LimeProgramming/NLIME_Slimes/README.md

> [!WARNING]
> This has not been made ***yet*** so not confirmed working. While you're free to make it anyway, do not blame me if it doesn't work. You have been warned.

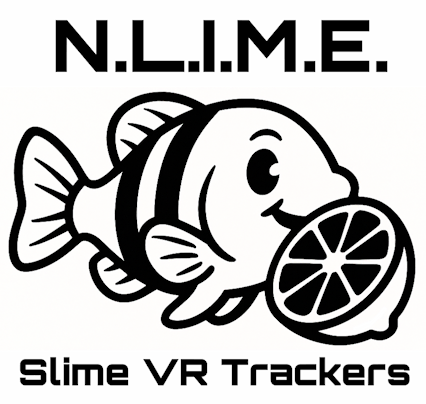
[picture p1: Images/LOGO/NLIME.webp]
NLime-Logo


## NLIME_Slimes
SMOL Slime VR trackers based around nRF52840, intended to be similar form factor to commercial Slimes but smaller.

I kinda like them. 

TODO: Write a proper read me maybe later. 

> [!NOTE]
> This was made with KICAD 9 and for some reason opening this project with KICAD 8 corrupts the PCB file.

> [!NOTE]
> Weird print settings
> 0.48 mm wall thickness
> layer 1 height 0.3mm
> layer height 0.26mm
