LimeProgramming/NLIME_Slimes/Images/Render/back-noTHT.png

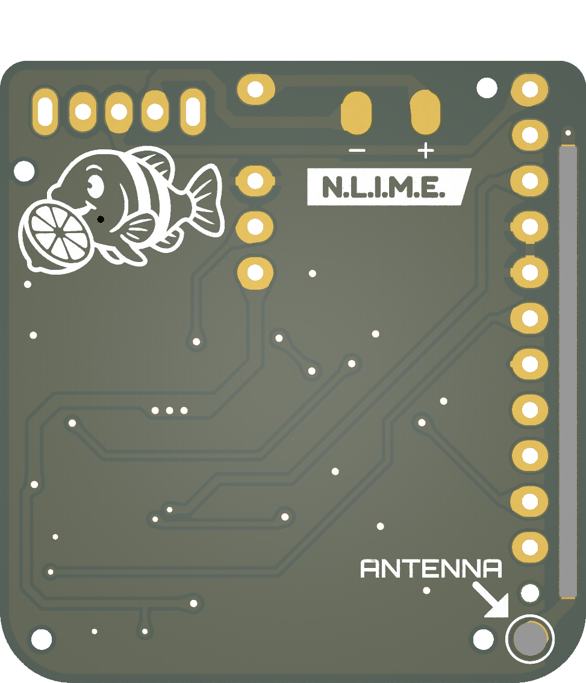
Images/Render/back-noTHT.png
