LimeProgramming/NLIME_Slimes/Images/Render/back-THT.png

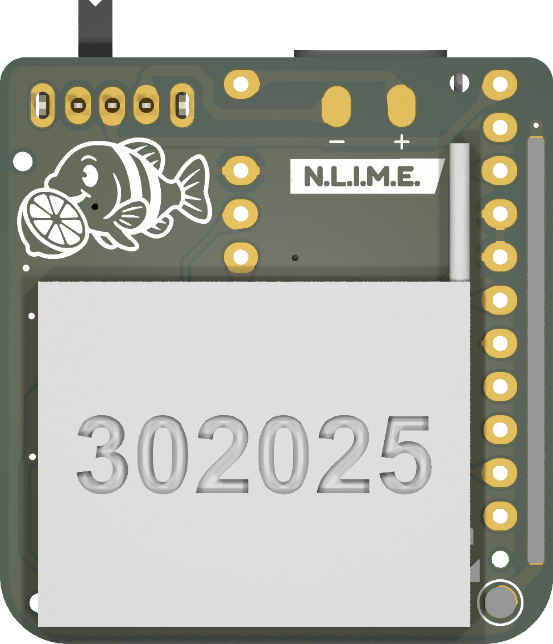
Images/Render/back-THT.png
