LimeProgramming/NLIME_Slimes/Images/Render/front-NOTHT.png

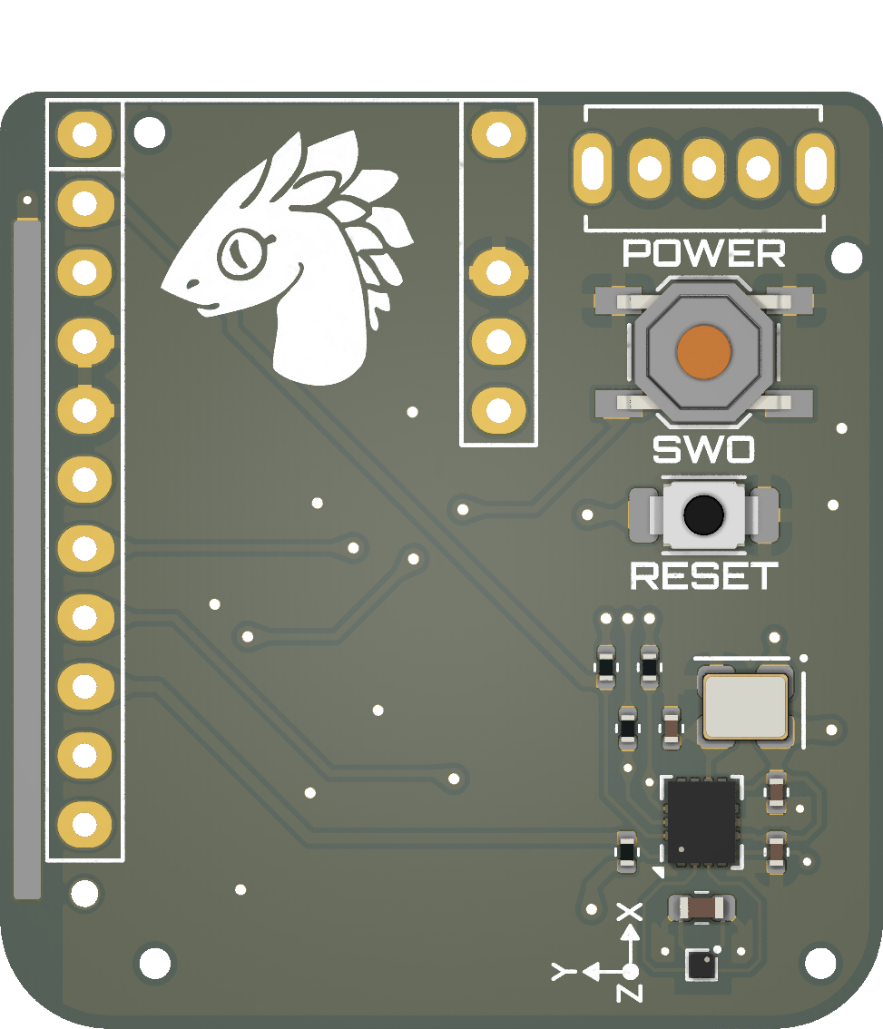
Images/Render/front-NOTHT.png
