LimeProgramming/NLIME_Slimes/Images/Render/front-THT.png

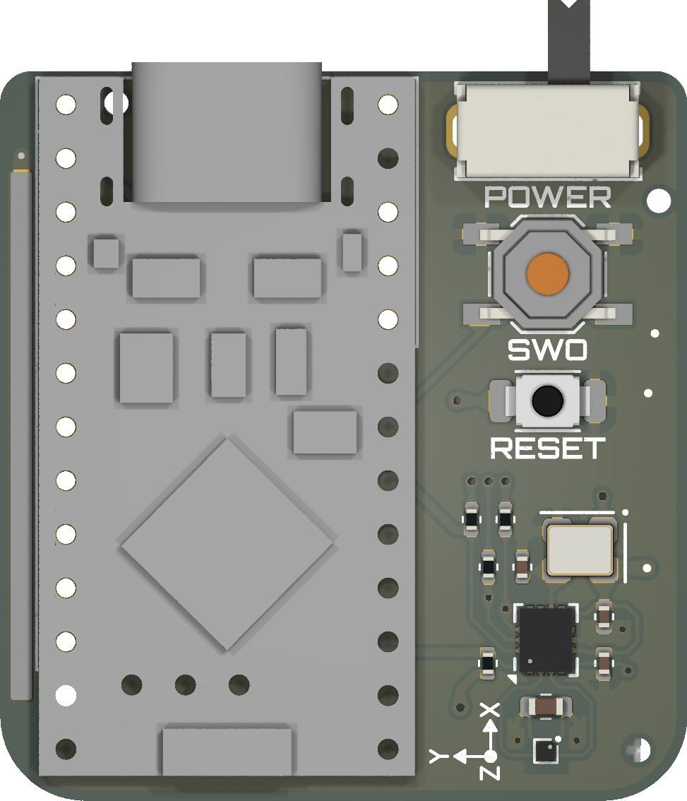
Images/Render/front-THT.png
