LimeProgramming/NLIME_Slimes/Case/Top Joined switchless.stl

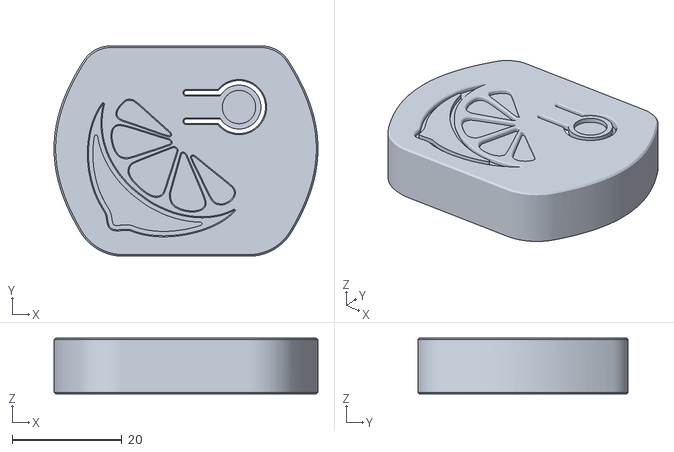
[picture p6: CAD file, 2025-08-19]
Case/Top Joined switchless.stl
48.1 x 38.3 x 10.2
