LimeProgramming/NLIME_Slimes/Case/Top Joined Switched.stl

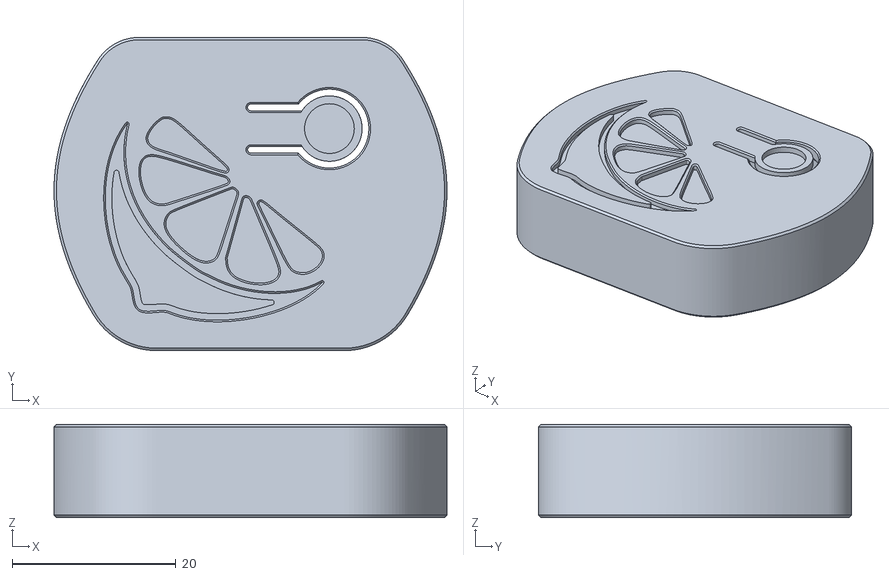
[picture p7: CAD file, 2025-08-19]
Case/Top Joined Switched.stl
48.1 x 38.3 x 11.4
