LimeProgramming/NLIME_Slimes/Case/Bottom 302025 curved straps.stl

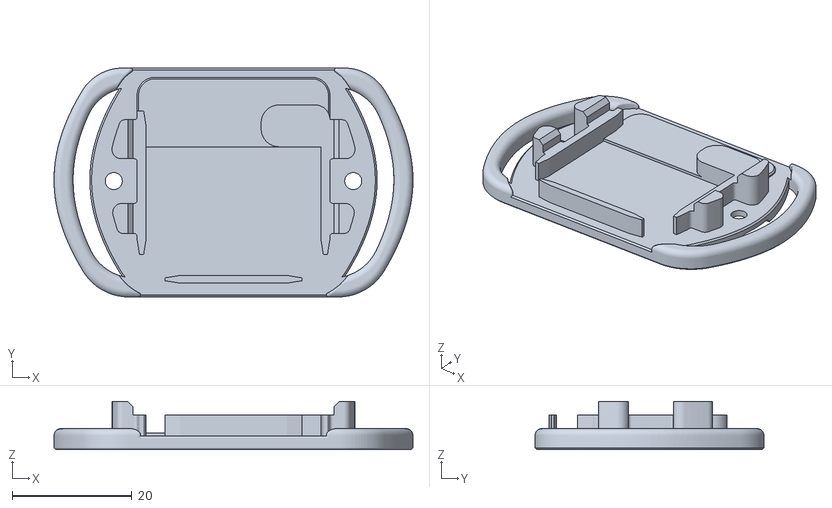
[picture p8: CAD file, 2025-08-19]
Case/Bottom 302025 curved straps.stl
60.0 x 38.3 x 8.05
