LimeProgramming/NLIME_Slimes/Case/bottom 302025 no straps v3.stl

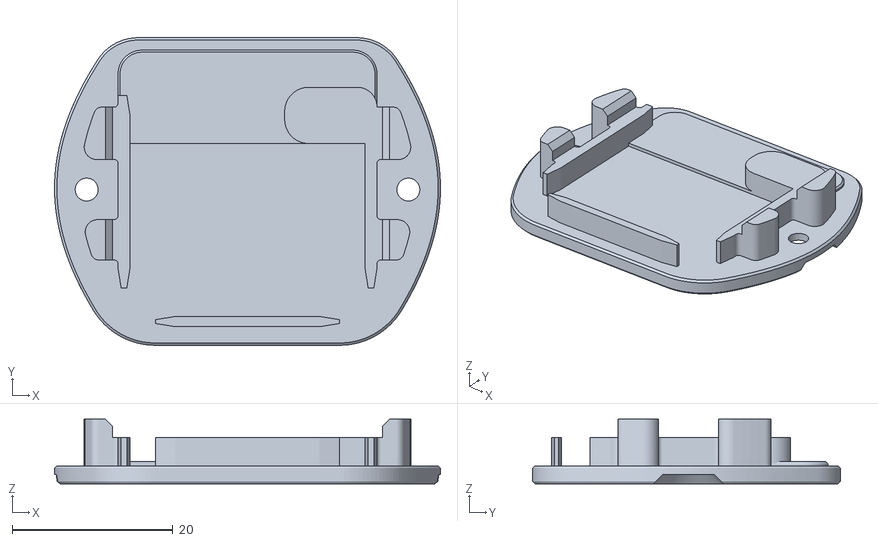
[picture p9: CAD file, 2025-08-19]
Case/bottom 302025 no straps v3.stl
48.1 x 38.3 x 8.05
