LimeProgramming/NLIME_Slimes/Case/bottom 502025 curved straps.stl

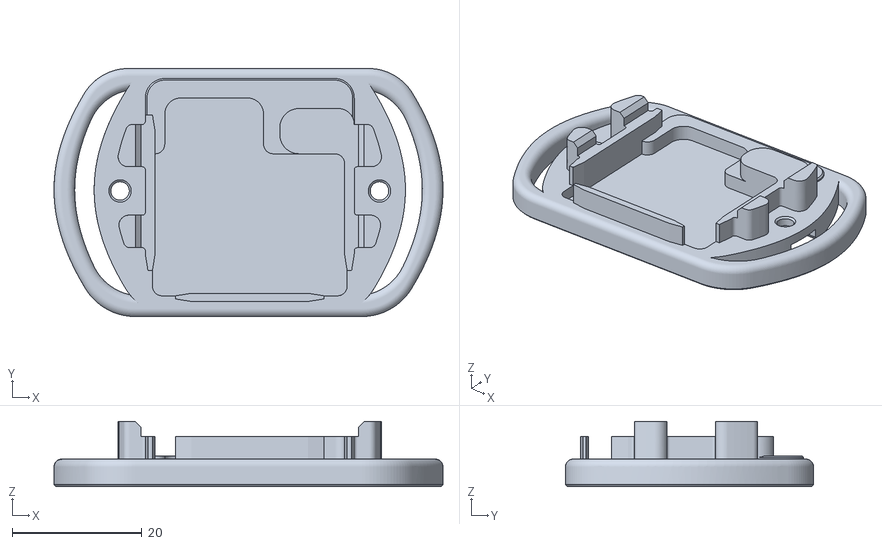
[picture p10: CAD file, 2025-08-19]
Case/bottom 502025 curved straps.stl
60.0 x 38.3 x 10.0
