LimeProgramming/NLIME_Slimes/Case/bottom 502025 no strap.stl

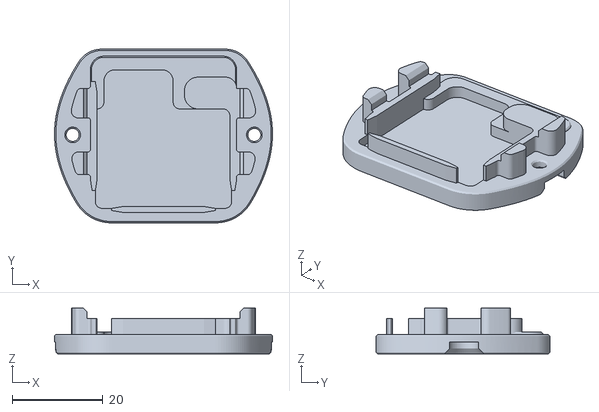
[picture p11: CAD file, 2025-08-19]
Case/bottom 502025 no strap.stl
48.1 x 38.3 x 10.0
