LimeProgramming/NLIME_Slimes/KICAD Files/NLIME_Slime.kicad_pcb

## KiCad design KICAD Files/NLIME_Slime.kicad_pcb (2025-08-19)

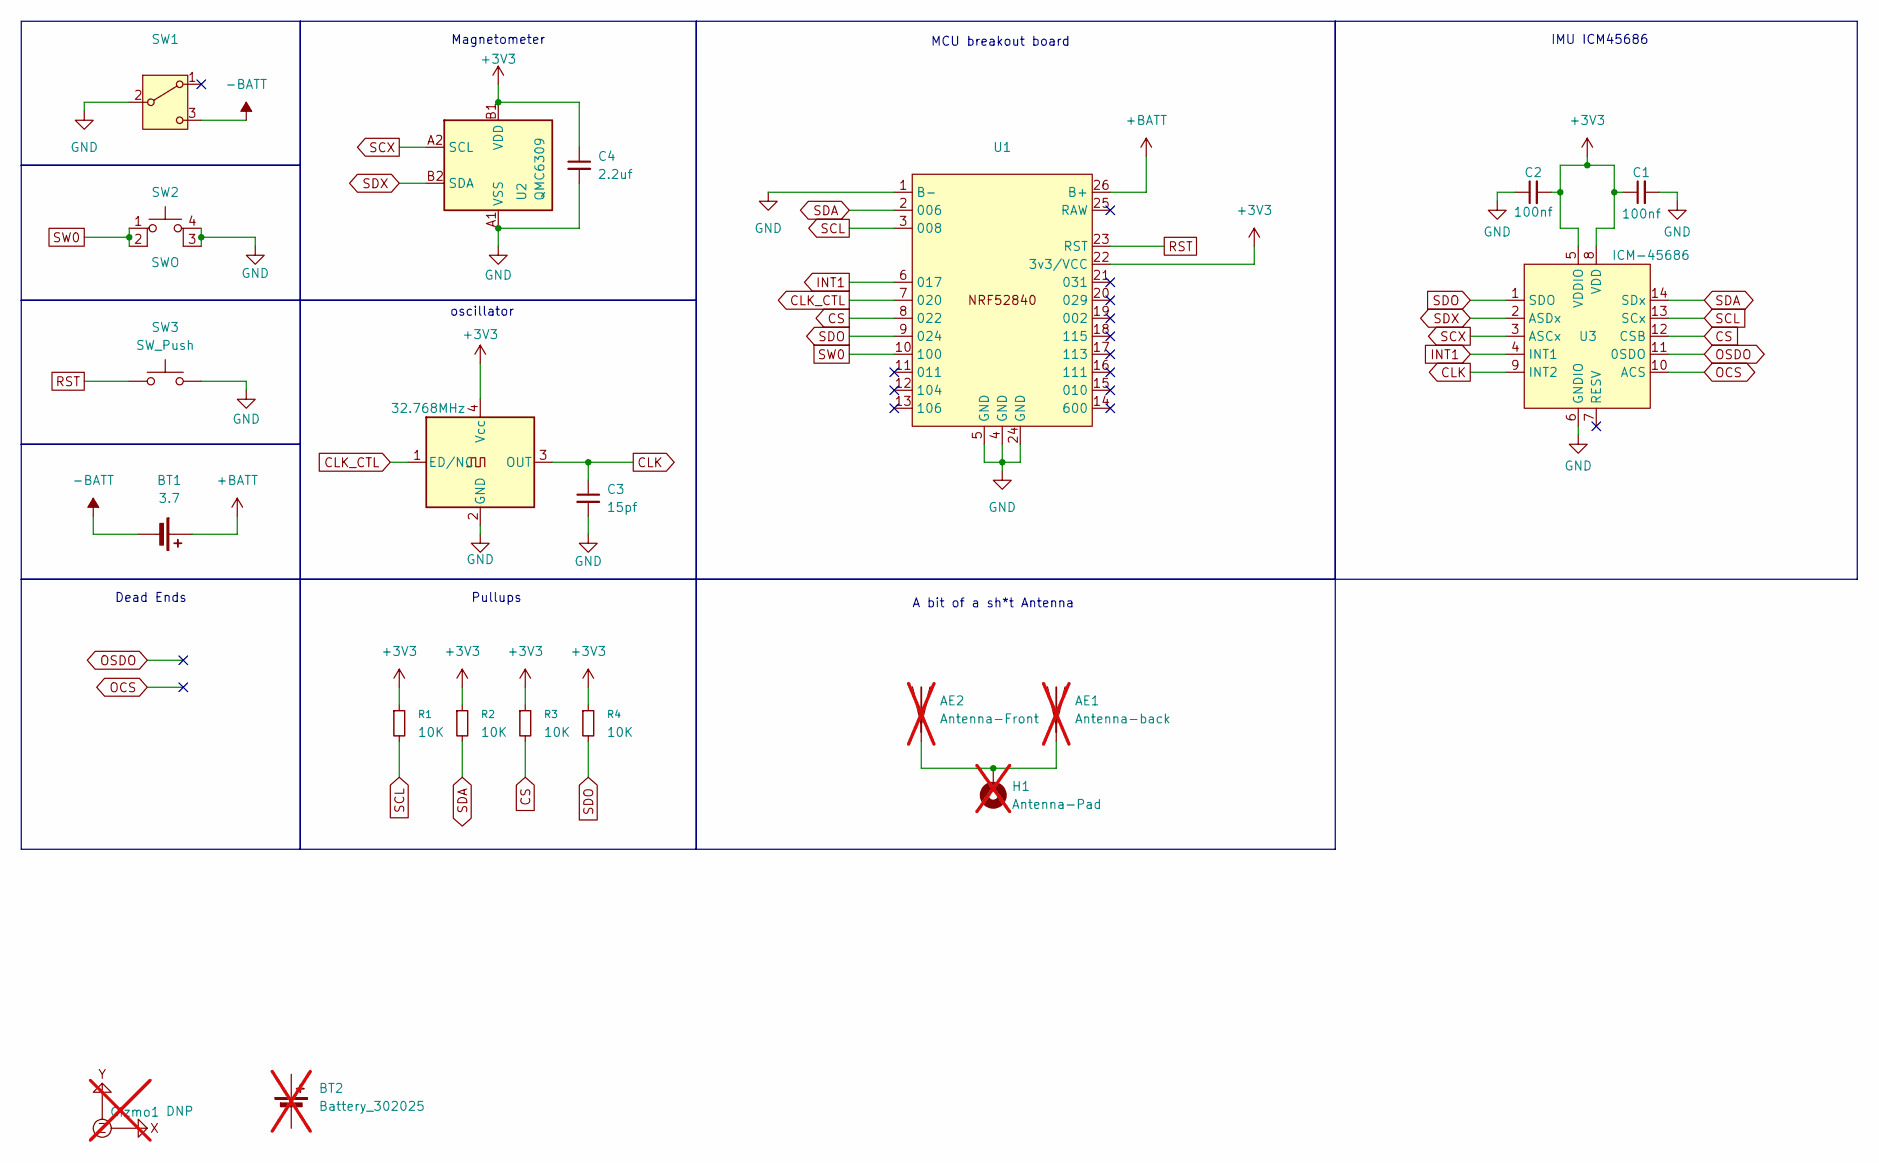
[picture p12: schematic NLIME_Slime.kicad_sch]

Parts:
AE1: Antenna-back; Antenna-Strip; not fitted
AE2: Antenna-Front; Antenna-Strip; not fitted
BT1: 3.7; Battery
BT2: Battery_302025; 302025 Bat Rep; not fitted
C1, C2: 100nf; C_0402_NOD; LCSC C1525
C3: 15pf; C_0402_NOD; LCSC C1548
C4: 2.2uf; C_0603_Rounded; LCSC C23630
Gizmo1: DNP; gizmo; not fitted
H1: Antenna-Pad; not fitted
R1, R2, R3, R4: 10K; R_0402_NOD; LCSC C25744
SW1: SW_Slide_SPDT_Angled_CK_OS102011MA1Q; LCSC C393937
SW2: SWO; SMT_SW; LCSC C318884
SW3: SW_Push; SW_Push_SPST_NO_Alps_SKRK; LCSC C720477
U1: nrf52840_stacked
U2: QMC6309; WLP-4_0.86x0.86mm_P0.4mm; LCSC C5439871
U3: ICM-45686; LGA-14_3x2.5mm_P0.5mm; LCSC C22459454
X1: 32.768MHz; Crystal_SMD_3225-4Pin_3.2x2.5mm; LCSC C454609

Connections:
+3V3: C1.1, C2.2, C4.1, R1.1, R2.1, R3.1, R4.1, U1.22 (3v3/VCC), U2.B1 (VDD), U3.5 (VDDIO), U3.8 (VDD), X1.4 (Vcc)
+BATT: BT1.1 (+), U1.26 (B+)
-BATT: BT1.2 (-), SW1.3 (C)
CLK: C3.1, U3.9 (INT2), X1.3 (OUT)
CLK_CTL: U1.7 (020), X1.1 (ED/NC)
CS: R3.2, U1.8 (022), U3.12 (CSB)
GND: C1.2, C2.1, C3.2, C4.2, SW1.2 (B), SW2.3 (K), SW2.4 (A), SW3.2, U1.1 (B-), U1.4 (GND), U1.5 (GND), U1.24 (GND), U2.A1 (VSS), U3.6 (GNDIO), X1.2 (GND)
INT1: U1.6 (017), U3.4 (INT1)
unnamed: AE1.1 (A), AE2.1 (A), H1.1 (MP)
OCS: U3.10 (ACS)
OSDO: U3.11 (0SDO)
RST: SW3.1, U1.23 (RST)
SCL: R1.2, U1.3 (008), U3.13 (SCx)
SCX: U2.A2 (SCL), U3.3 (ASCx)
SDA: R2.2, U1.2 (006), U3.14 (SDx)
SDO: R4.2, U1.9 (024), U3.1 (SDO)
SDX: U2.B2 (SDA), U3.2 (ASDx)
SW0: SW2.1, SW2.2, U1.10 (100)

Notes on the sheet:
MCU breakout board
oscillator
Pullups
IMU ICM45686
A bit of a sh*t Antenna
Dead Ends
Magnetometer

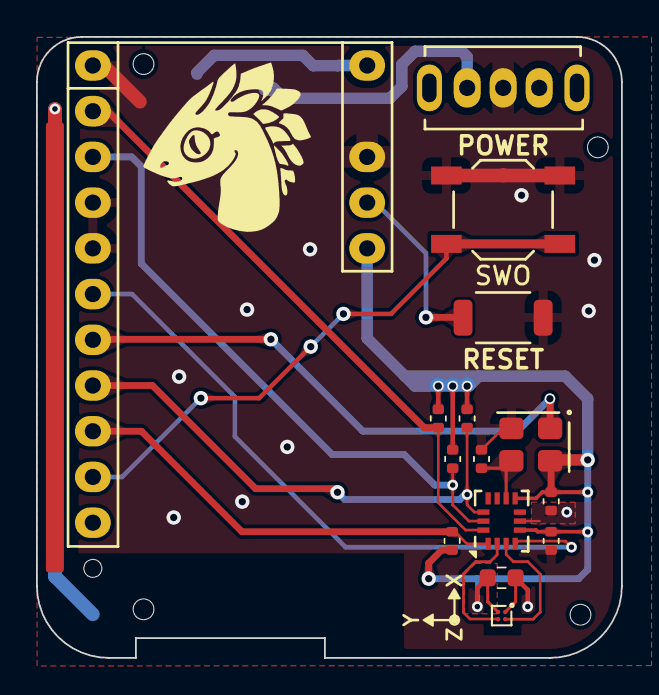
[picture p13: board NLIME_Slime.kicad_pcb from above]

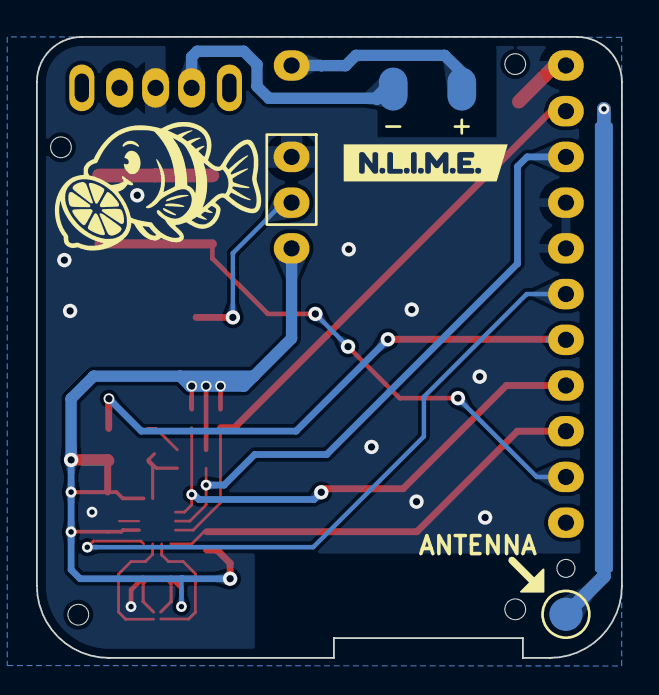
[picture p14: board NLIME_Slime.kicad_pcb from below]

Board: 4 copper layers, 32.5 x 34.5 mm, 22 parts (5 on the bottom side), 16 nets.

Other parts of the board:
kibuzzard-68618D06: G***; kibuzzard-68618D06
