LimeProgramming/NLIME_Slimes/(notices)

Notices in the files:
README.md:
License: Personal Use Only
